UWCubeSat/minimee-electronics/containment/containment-simple.kicad_pcb

## KiCad design containment/containment-simple.kicad_pcb (2021-06-10)

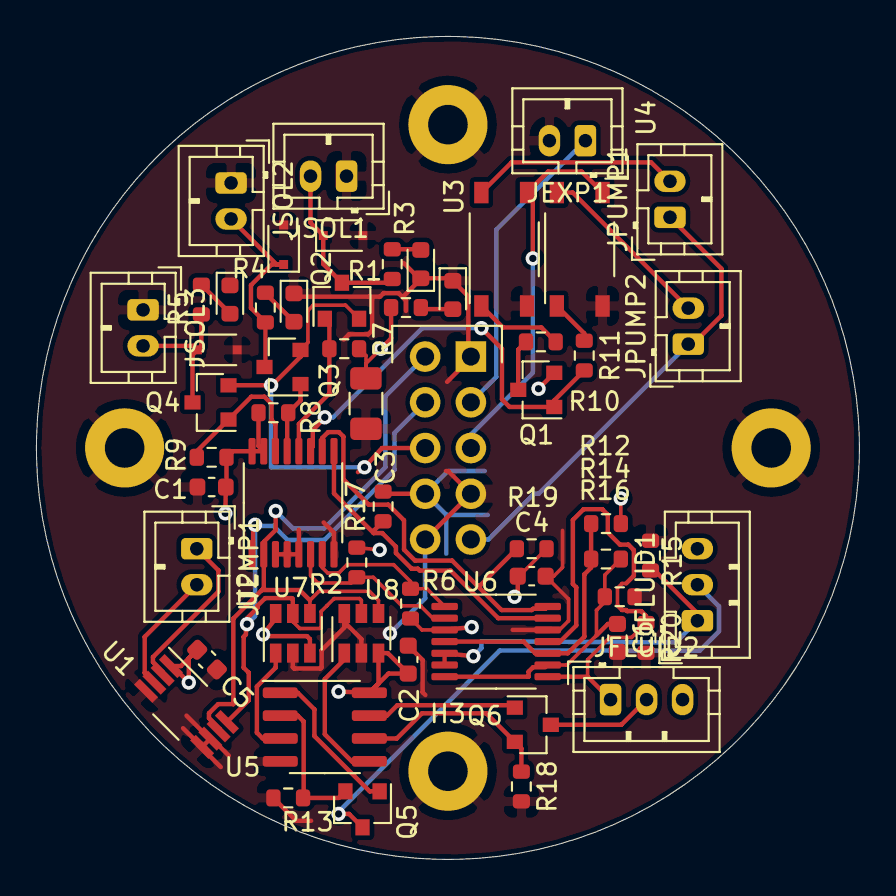
[picture p3: board containment-simple.kicad_pcb from above]

Board: 2 copper layers, 45.7 x 45.7 mm, 61 parts (1 on the bottom side), 42 nets.

Parts:
C1, C2, C4, C5, C6: .1uF; C_0603_1608Metric
C3: 10uF; C_1206_3216Metric
D1, D5, D7, D9: LED; LED_0603_1608Metric
D4, D6, D8: D; D_SOD-323F
H1, H2, H3, H4: MountingHole_Pad; MountingHole_2-56_ExtraClearance
J1: Conn_02x05_Odd_Even; PinHeader_2x05_P2.54mm_Vertical
JEXP1: Conn_01x02; JST_PH_B2B-PH-K_1x02_P2.00mm_Vertical
JFLUID1, JFLUID2: Conn_01x03; JST_PH_B3B-PH-K_1x03_P2.00mm_Vertical
JPUMP1, JPUMP2: Conn_01x02; JST_PH_B2B-PH-K_1x02_P2.00mm_Vertical
JSOL1, JSOL2, JSOL3: Conn_01x02; JST_PH_B2B-PH-K_1x02_P2.00mm_Vertical
JTEMP1: Conn_01x02; JST_PH_B2B-PH-K_1x02_P2.00mm_Vertical
Q1, Q2, Q3, Q4: BSS84; SOT-23
Q5, Q6: BC846; SOT-23
R1, R3, R4, R5: 1k; R_0603_1608Metric
R2, R6, R7, R8, R9, R12, R14, R15, R16, R17, R19, R20: 10k; R_0603_1608Metric
R10, R11: 470; R_0603_1608Metric
R13, R18: 50; R_0603_1608Metric
U1: TMP411; VSSOP-8_3.0x3.0mm_P0.65mm
U2: PCA9557; TSSOP-16_4.4x5mm_P0.65mm
U3, U4: TLP175A; MFSOP6-4_4.4x3.6mm_P1.27mm
U5: LM358; SOIC-8_3.9x4.9mm_P1.27mm
U6: LM339; TSSOP-14_4.4x5mm_P0.65mm
U7, U8: MCP4725xxx-xCH; SOT-23-6

Connections:
+5V: C1.1, C2.1, C3.1, C4.1, C5.1, J1.8, JFLUID1.3, JFLUID2.3, Q1.2, R1.1, R2.1, R6.1, R7.1, R8.1, R9.1, R12.1, R17.1, R19.1, U1.1, U2.15, U2.16, U5.8, U6.3, U7.3, U7.6, U8.3
+12V: J1.6, Q2.2, Q3.2, Q4.2
/Fluid Sensors/1_3rds: C6.1, R14.2, R16.1, U6.7, U6.9
/Fluid Sensors/2_3rds: R12.2, R14.1, U6.4, U6.10
/HV+: J1.9, JPUMP1.1, JPUMP2.1
/HV-: J1.5, U3.4, U4.4
/experiment: J1.3, JEXP1.1
/p0: R2.2, U2.6, U6.2
/p1: R6.2, U2.7, U6.1
/p2: R17.2, U2.9, U6.13
/p3: R19.2, U2.10, U6.14
/p4: Q1.1, R11.2, U2.11
/p5: Q2.1, R7.2, U2.12
/p6: Q3.1, R8.2, U2.13
/p7: Q4.1, R9.2, U2.14
GND: C1.2, C2.2, C3.2, C4.2, C5.2, C6.2, D1.1, D4.2, D5.1, D6.2, D7.1, D8.2, D9.1, H1.1, H2.1, H3.1, H4.1, J1.1, J1.7, J1.10, JEXP1.2, JSOL1.1, JSOL2.1, JSOL3.1, R13.2, R15.2, R16.2, R18.2, R20.2, U1.4, U1.5, U1.6, U2.3, U2.4, U2.5, U2.8, U3.3, U4.3, U5.4, U6.12, U7.2, U8.2, U8.6
unnamed: D1.2, R1.2
unnamed: D4.1, JSOL1.2, Q2.3, R3.1
unnamed: D5.2, R3.2
unnamed: D6.1, JSOL2.2, Q3.3, R4.1
unnamed: D7.2, R4.2
unnamed: D8.1, JSOL3.2, Q4.3, R5.1
unnamed: D9.2, R5.2
unnamed: JFLUID1.1, R15.1, U6.5, U6.6
unnamed: JFLUID1.2, Q5.3
unnamed: JFLUID2.1, R20.1, U6.8, U6.11
unnamed: JFLUID2.2, Q6.3
unnamed: JPUMP1.2, U3.6
unnamed: JPUMP2.2, U4.6
unnamed: JTEMP1.1, U1.2
unnamed: JTEMP1.2, U1.3
unnamed: Q1.3, R10.2
unnamed: Q5.1, U5.1
unnamed: Q5.2, R13.1, U5.2
unnamed: Q6.1, U5.7
unnamed: Q6.2, R18.1, U5.6
unnamed: R10.1, U3.1
unnamed: R11.1, U4.1
unnamed: U5.3, U7.1
unnamed: U5.5, U8.1
scl: J1.4, U1.8, U2.1, U7.5, U8.5
sda: J1.2, U1.7, U2.2, U7.4, U8.4
