UWCubeSat/minimee-electronics/spaceduino/spaceduino.kicad_pcb

## KiCad design spaceduino/spaceduino.kicad_pcb (2021-04-05)

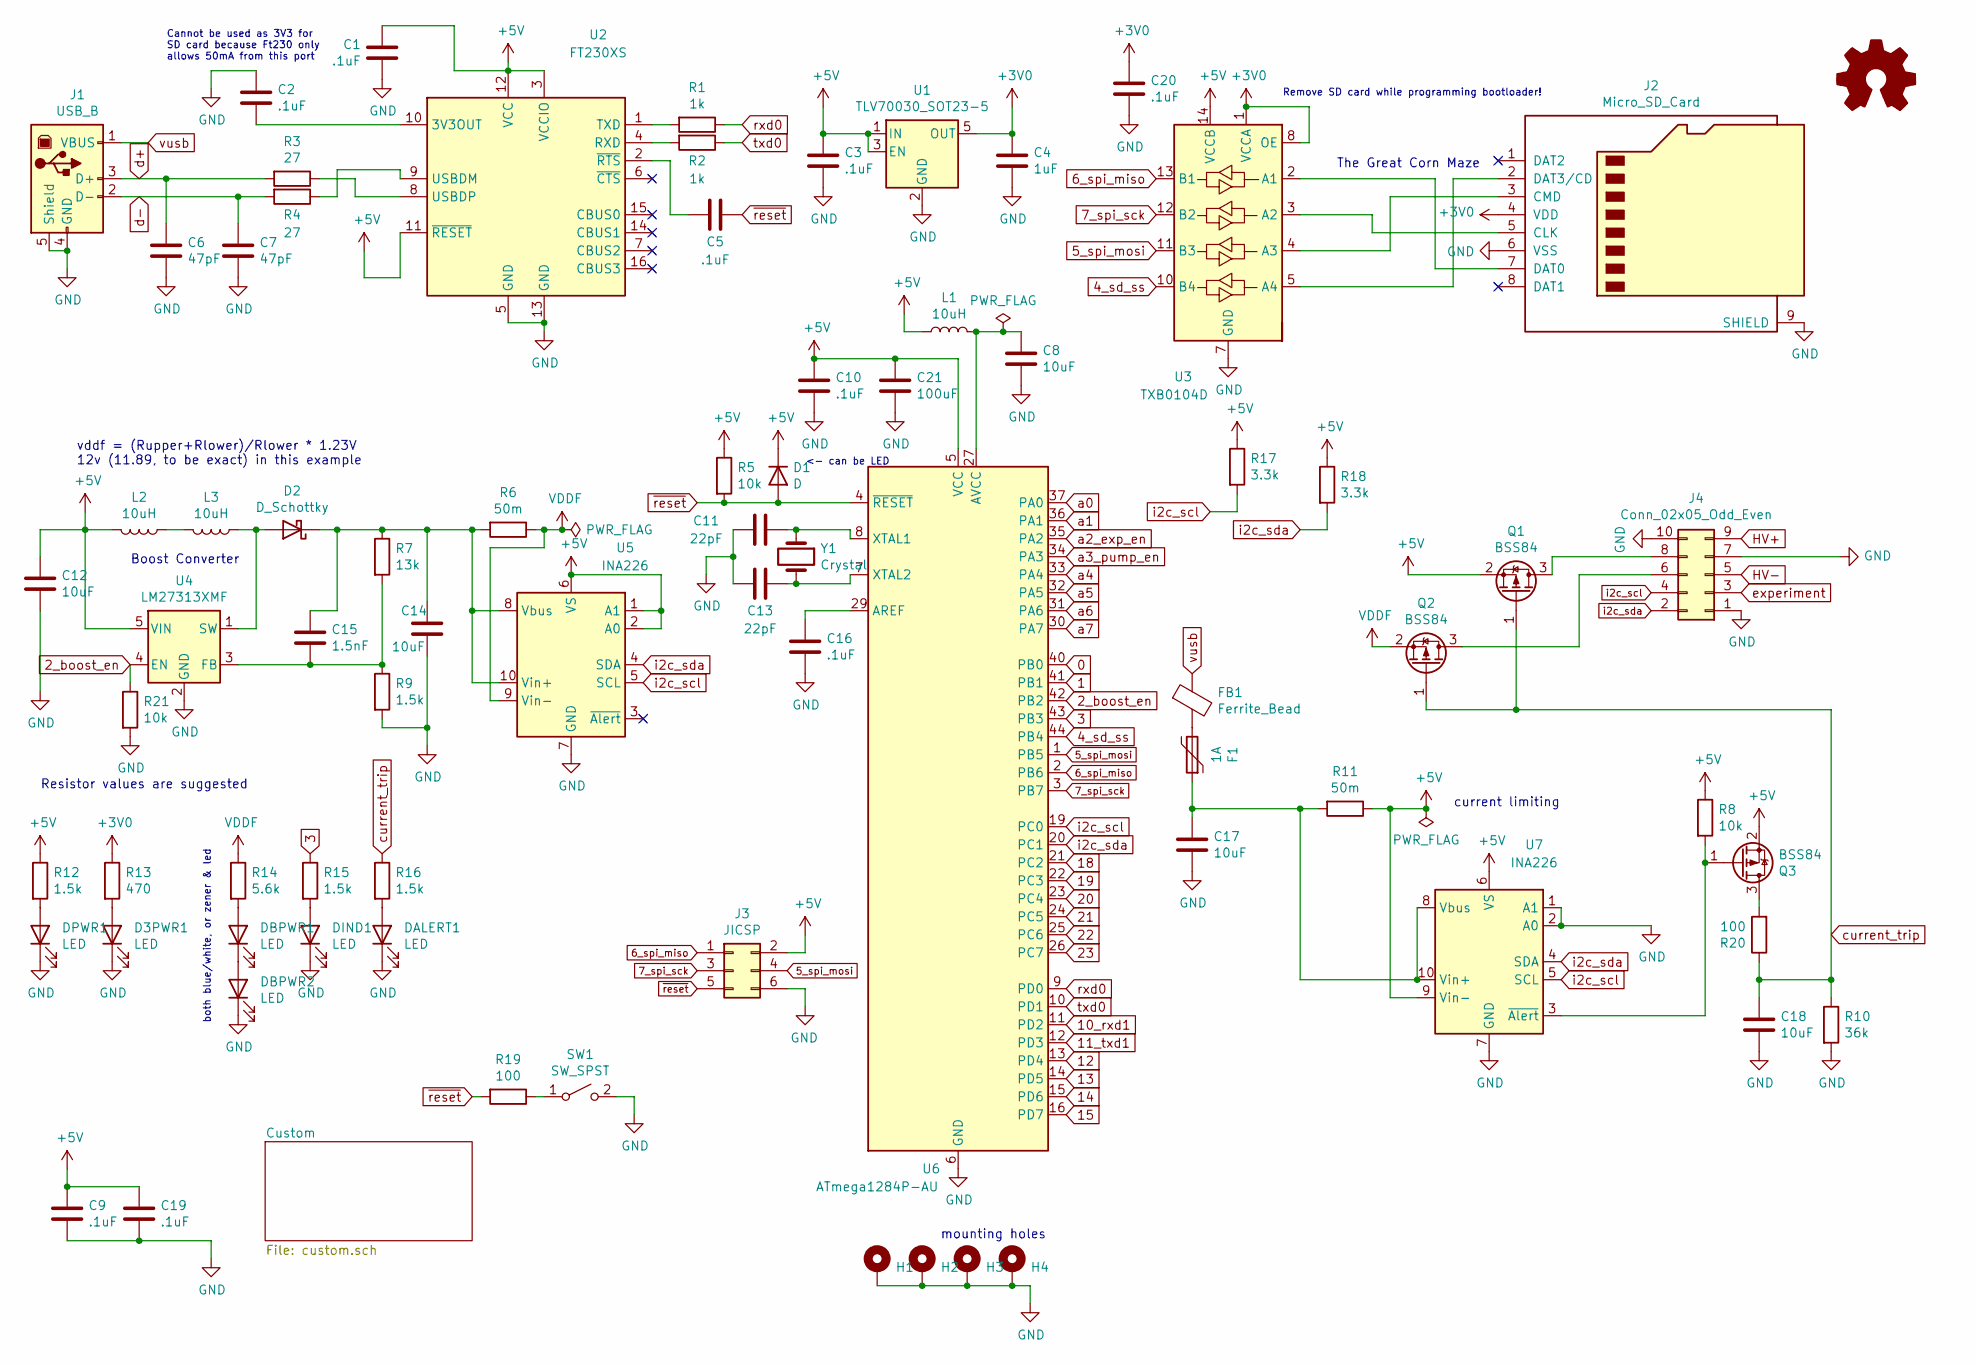
[picture p4: schematic spaceduino.sch]

Parts:
C1, C2, C3, C5, C9, C10, C16, C19, C20: .1uF; C_0603_1608Metric; LCSC C14663
C4: 1uF; C_1206_3216Metric; LCSC C1848
C6, C7: 47pF; C_0603_1608Metric; LCSC C1671
C8, C12, C14, C17, C18: 10uF; C_1206_3216Metric; LCSC C13585
C11, C13: 22pF; C_0603_1608Metric; LCSC C1653
C15: 1.5nF; C_0603_1608Metric; LCSC C1595
C21: 100uF; C_Radial_D5.0mm_H11.0mm_P2.00mm
D1: D; D_SOD-123; LCSC C8598
D2: D_Schottky; D_SOD-123; LCSC C8598
D3PWR1: LED; LED_0603_1608Metric; LCSC C72041
DALERT1: LED; LED_0603_1608Metric; LCSC C2286
DBPWR1, DBPWR2: LED; LED_0603_1608Metric; LCSC C72041
DIND1: LED; LED_0603_1608Metric; LCSC C72041
DPWR1: LED; LED_0603_1608Metric; LCSC C72041
F1: 1A; Fuse_1206_3216Metric; LCSC C315895
FB1: Ferrite_Bead; L_1206_3216Metric; LCSC C131463
H1, H2, H3, H4: MountingHole_Pad; MountingHole_2.2mm_M2_Pad
J1: USB_B; usb-type-b; Digikey 732-2734-ND
J2: Micro_SD_Card; HRS_DM3CS-SF
J3: JICSP; PinHeader_2x03_P2.54mm_Vertical
J4: Conn_02x05_Odd_Even; PinHeader_2x05_P2.54mm_Vertical
L1, L2, L3: 10uH; L_1210_3225Metric; LCSC C86073
LOGO1: Logo_Open_Hardware_Small; spaceduino-logo
Q1, Q2, Q3: BSS84; SOT-23; LCSC C10487
R1, R2: 1k; R_1206_3216Metric; LCSC C4410
R3, R4: 27; R_0603_1608Metric; LCSC C25190
R5, R8, R21: 10k; R_1206_3216Metric; LCSC C17902
R6, R11: 50m; R_1206_3216Metric; LCSC C201301
R7: 13k; R_0603_1608Metric; LCSC C22797
R9, R12, R15, R16: 1.5k; R_0603_1608Metric; LCSC C22843
R10: 36k; R_0603_1608Metric; LCSC C23147
R13: 470; R_1206_3216Metric; LCSC C17936
R14: 5.6k; R_0603_1608Metric; LCSC C23189
R17, R18: 3.3k; R_0603_1608Metric; LCSC C22978
R19, R20: 100; R_1206_3216Metric; LCSC C17901
SW1: SW_SPST; SolderJumper-2_P1.3mm_Open_TrianglePad1.0x1.5mm
U1: TLV70030_SOT23-5; SOT-23-5; Digikey 296-32412-1-ND
U2: FT230XS; SSOP-16_3.9x4.9mm_P0.635mm; Digikey 768-1135-1-ND
U3: TXB0104D; TSSOP-14_4.4x5mm_P0.65mm; Digikey 296-21928-1-ND
U4: LM27313XMF; SOT-23-5; LCSC C32355
U5, U7: INA226; VSSOP-10_3x3mm_P0.5mm; LCSC C49851
U6: ATmega1284P-AU; TQFP-44_10x10mm_P0.8mm; Digikey ATMEGA1284P-AURCT-ND
Y1: Crystal; Crystal_HC49-U_Vertical

Connections:
0: U6.40 (PB0)
1: U6.41 (PB1)
2_boost_en: R21.1, U4.4 (EN), U6.42 (PB2)
3: R15.1, U6.43 (PB3)
4_sd_ss: U3.10 (B4), U6.44 (PB4)
5_spi_mosi: J3.4, U3.11 (B3), U6.1 (PB5)
6_spi_miso: J3.1, U3.13 (B1), U6.2 (PB6)
7_spi_sck: J3.3, U3.12 (B2), U6.3 (PB7)
10_rxd1: U6.11 (PD2)
11_txd1: U6.12 (PD3)
12: U6.13 (PD4)
13: U6.14 (PD5)
14: U6.15 (PD6)
15: U6.16 (PD7)
18: U6.21 (PC2)
19: U6.22 (PC3)
20: U6.23 (PC4)
21: U6.24 (PC5)
22: U6.25 (PC6)
23: U6.26 (PC7)
+3V0: C4.1, C20.1, J2.4 (VDD), R13.1, U1.5 (OUT), U3.1 (VCCA), U3.8 (OE)
+5V: C1.1, C3.1, C9.1, C10.1, C12.1, C19.1, C21.1, D1.1 (K), J3.2, L1.1, L2.2, Q1.2 (S), Q3.2 (S), R5.1, R8.1, R11.1, R12.1, R17.1, R18.1, U1.1 (IN), U1.3 (EN), U2.3 (VCCIO), U2.11 (~RESET), U2.12 (VCC), U3.14 (VCCB), U4.5 (VIN), U5.1 (A1), U5.2 (A0), U5.6 (VS), U6.5 (VCC), U6.17 (VCC), U6.38 (VCC), U7.6 (VS), U7.9 (Vin-); also elsewhere on the board
GND: C1.2, C2.1, C3.2, C4.2, C6.2, C7.2, C8.2, C9.2, C10.2, C11.2, C12.2, C13.2, C14.2, C16.2, C17.2, C18.2, C19.2, C20.2, C21.2, D3PWR1.1 (K), DALERT1.1 (K), DBPWR2.1 (K), DIND1.1 (K), DPWR1.1 (K), H1.1, H2.1, H3.1, H4.1, J1.4 (GND), J1.5 (Shield), J2.6 (VSS), J2.9 (SHIELD), J3.6, J4.1, J4.7, J4.10, R9.2, R10.2, R21.2, SW1.2 (B), U1.2 (GND), U2.5 (GND), U2.13 (GND), U3.7 (GND), U4.2 (GND), U5.7 (GND), U6.6 (GND), U6.18 (GND), U6.28 (GND), U6.39 (GND), U7.1 (A1), U7.2 (A0), U7.7 (GND); also elsewhere on the board
HV+: J4.9; also elsewhere on the board
HV-: J4.5; also elsewhere on the board
unnamed: C2.2, U2.10 (3V3OUT)
unnamed: C5.2, U2.2 (~RTS)
unnamed: C8.1, L1.2, U6.27 (AVCC)
unnamed: C11.1, U6.8 (XTAL1), Y1.1
unnamed: C13.1, U6.7 (XTAL2), Y1.2
unnamed: C14.1, C15.1, D2.1 (K), R6.2, R7.1, U5.8 (Vbus), U5.10 (Vin+)
unnamed: C15.2, R7.2, R9.1, U4.3 (FB)
unnamed: C16.1, U6.29 (AREF)
unnamed: C17.1, F1.1, R11.2, U7.8 (Vbus), U7.10 (Vin+)
unnamed: D2.2 (A), L3.1, U4.1 (SW)
unnamed: D3PWR1.2 (A), R13.2
unnamed: DALERT1.2 (A), R16.2
unnamed: DBPWR1.1 (K), DBPWR2.2 (A)
unnamed: DBPWR1.2 (A), R14.2
unnamed: DIND1.2 (A), R15.2
unnamed: DPWR1.2 (A), R12.2
unnamed: F1.2, FB1.2
unnamed: J2.2 (DAT3/CD), U3.5 (A4)
unnamed: J2.3 (CMD), U3.4 (A3)
unnamed: J2.5 (CLK), U3.3 (A2)
unnamed: J2.7 (DAT0), U3.2 (A1)
unnamed: J4.6, Q2.3 (D)
unnamed: J4.8, Q1.3 (D)
unnamed: L2.1, L3.2
unnamed: Q3.1 (G), R8.2, U7.3 (~Alert~)
unnamed: Q3.3 (D), R20.2
unnamed: R1.2, U2.1 (TXD)
unnamed: R2.2, U2.4 (RXD)
unnamed: R3.1, U2.8 (USBDP)
unnamed: R4.1, U2.9 (USBDM)
unnamed: R19.1, SW1.1 (A)
VDDF: Q2.2 (S), R6.1, R14.1, U5.9 (Vin-)
a0: U6.37 (PA0)
a1: U6.36 (PA1)
a2_exp_en: U6.35 (PA2); also elsewhere on the board
a3_pump_en: U6.34 (PA3); also elsewhere on the board
a4: U6.33 (PA4)
a5: U6.32 (PA5)
a6: U6.31 (PA6)
a7: U6.30 (PA7)
current_trip: C18.1, Q1.1 (G), Q2.1 (G), R10.1, R16.1, R20.1
d+: C6.1, J1.3 (D+), R3.2
d-: C7.1, J1.2 (D-), R4.2
experiment: J4.3; also elsewhere on the board
i2c_scl: J4.4, R17.2, U5.5 (SCL), U6.19 (PC0), U7.5 (SCL); also elsewhere on the board
i2c_sda: J4.2, R18.2, U5.4 (SDA), U6.20 (PC1), U7.4 (SDA); also elsewhere on the board
rxd0: R1.1, U6.9 (PD0)
txd0: R2.1, U6.10 (PD1)
vusb: FB1.1, J1.1 (VBUS)
~reset: C5.1, D1.2 (A), J3.5, R5.2, R19.2, U6.4 (~RESET)

Notes on the sheet:
Boost Converter
The Great Corn Maze
Cannot be used as 3V3 for SD card because Ft230 only allows 50mA from this port
Remove SD card while programming bootloader!
vddf = (Rupper+Rlower)/Rlower * 1.23V 12v (11.89, to be exact) in this example
Resistor values are suggested
mounting holes
current limiting
<- can be LED
both blue/white, or zener & led

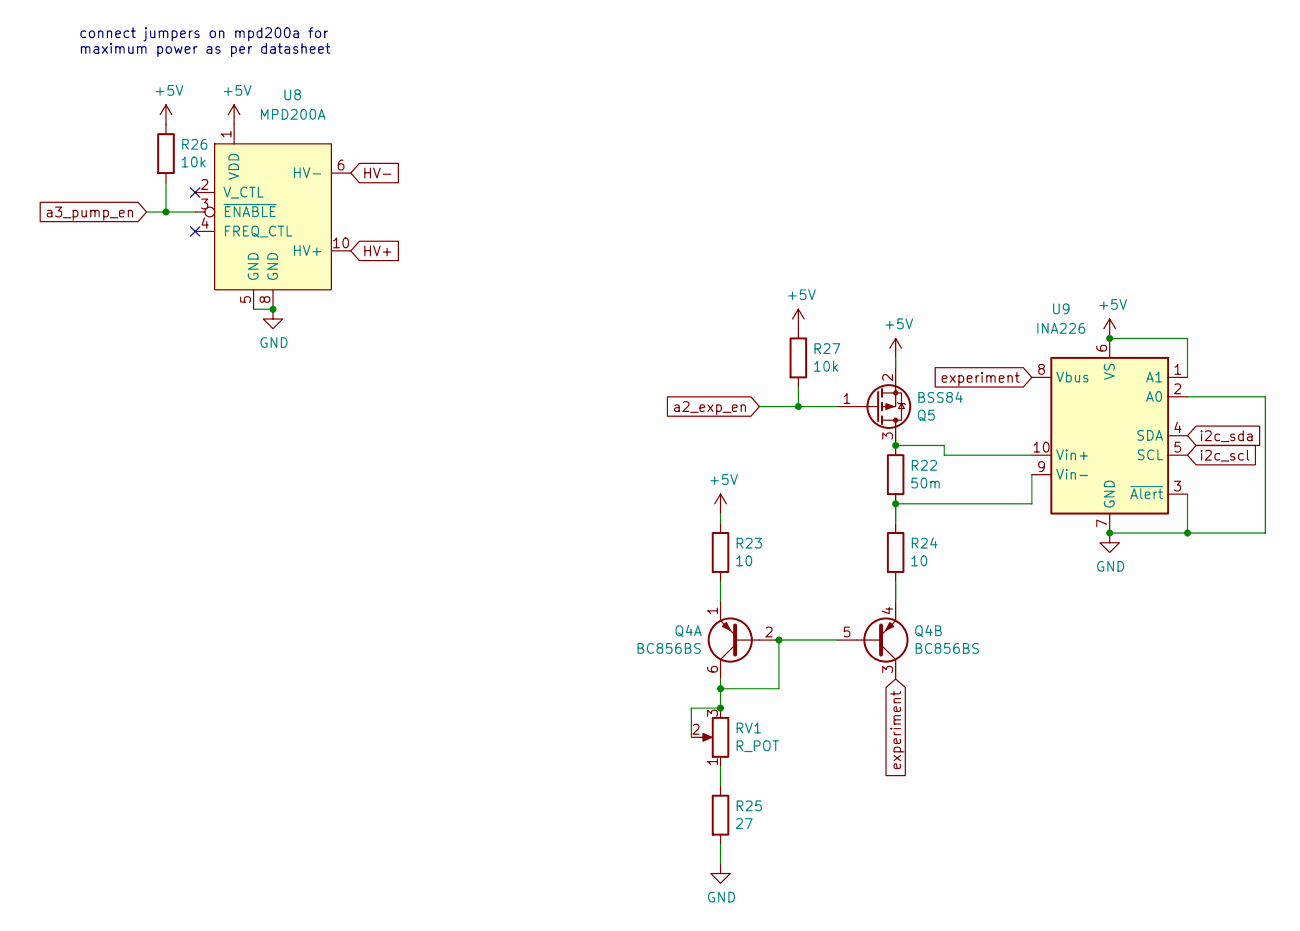
[picture p5: schematic custom.sch]

Parts:
Q4: BC856BS; SOT-363_SC-70-6; LCSC C105896
Q5: BSS84; SOT-23; LCSC C10487
R22: 50m; R_1206_3216Metric; LCSC C201301
R23, R24: 10; R_1206_3216Metric; LCSC C17903
R25: 27; R_0603_1608Metric; LCSC C25190
R26, R27: 10k; R_1206_3216Metric; LCSC C17902
RV1: R_POT; Potentiometer_Bourns_3296Y_Vertical
U8: MPD200A
U9: INA226; VSSOP-10_3x3mm_P0.5mm; LCSC C49851

Connections:
+5V: Q5.2 (S), R23.1, R26.1, R27.1, U8.1 (VDD), U9.1 (A1), U9.6 (VS); also elsewhere on the board
GND: R25.2, U8.5 (GND), U8.8 (GND), U9.2 (A0), U9.3 (~Alert~), U9.7 (GND); also elsewhere on the board
HV+: U8.10 (HV+); also elsewhere on the board
HV-: U8.6 (HV-); also elsewhere on the board
unnamed: Q4.1 (E1), R23.2
unnamed: Q4.2 (B1), Q4.5 (B2), Q4.6 (C1), RV1.2, RV1.3
unnamed: Q4.4 (E2), R24.2
unnamed: Q5.3 (D), R22.1, U9.10 (Vin+)
unnamed: R22.2, R24.1, U9.9 (Vin-)
unnamed: R25.1, RV1.1
a2_exp_en: Q5.1 (G), R27.2; also elsewhere on the board
a3_pump_en: R26.2, U8.3 (~ENABLE); also elsewhere on the board
experiment: Q4.3 (C2), U9.8 (Vbus); also elsewhere on the board
i2c_scl: U9.5 (SCL); also elsewhere on the board
i2c_sda: U9.4 (SDA); also elsewhere on the board

Notes on the sheet:
connect jumpers on mpd200a for maximum power as per datasheet

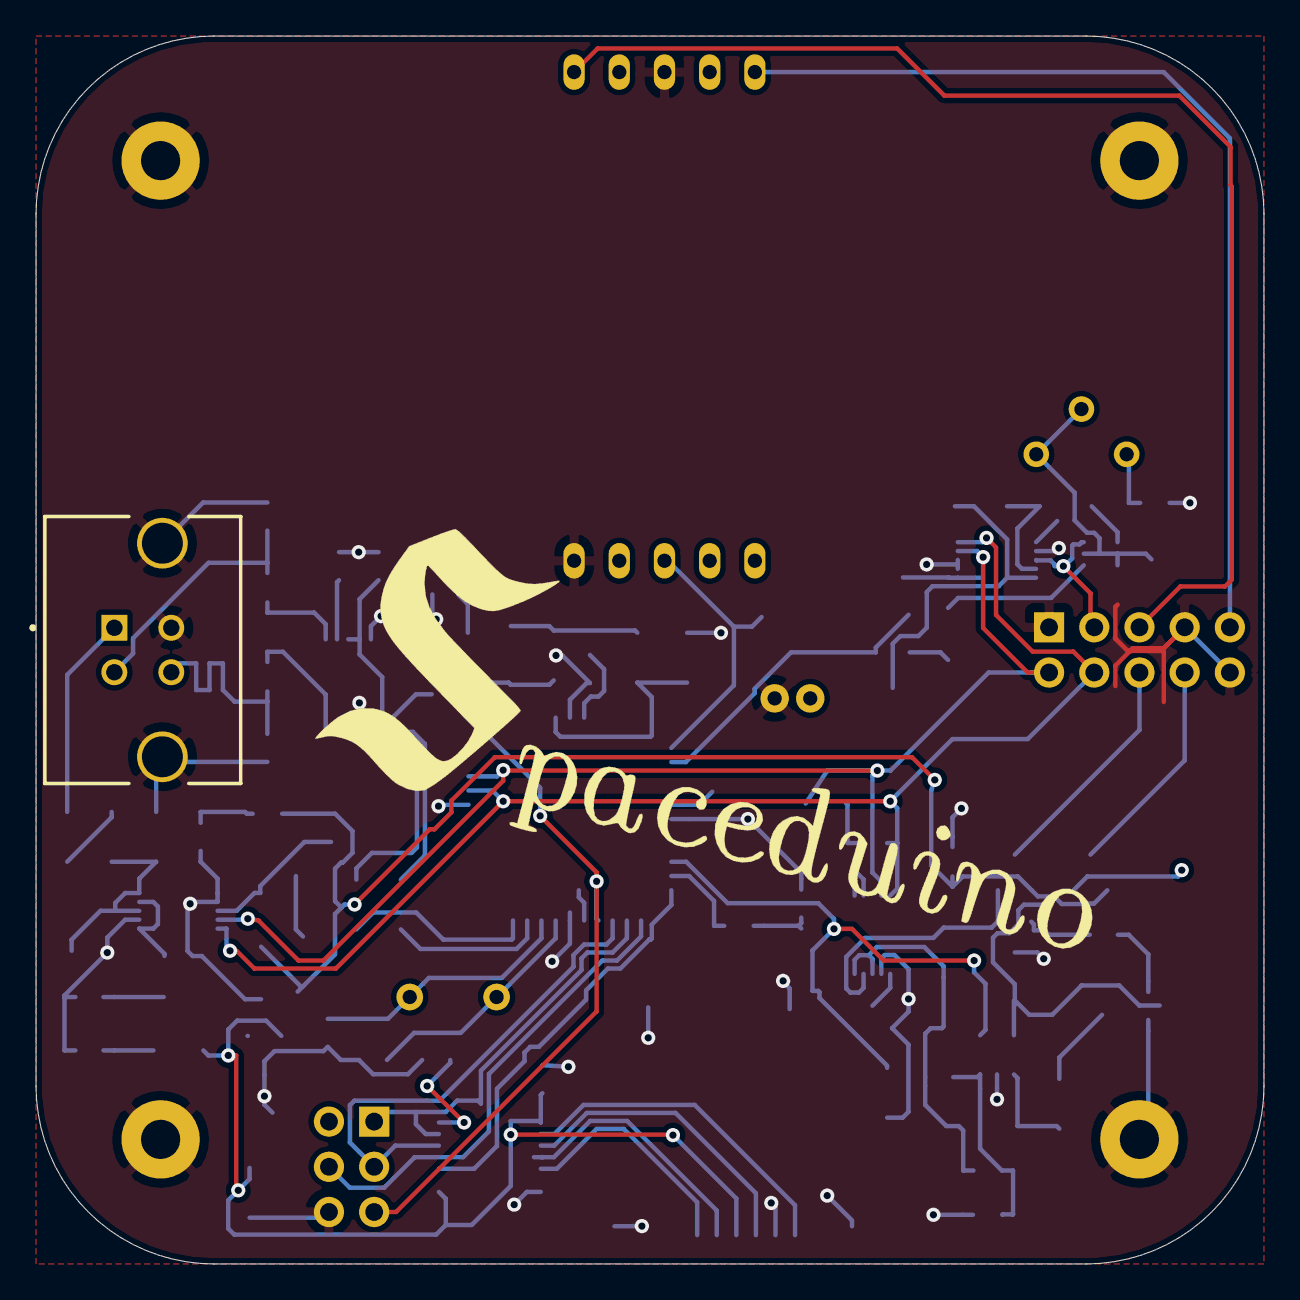
[picture p6: board spaceduino.kicad_pcb from above]

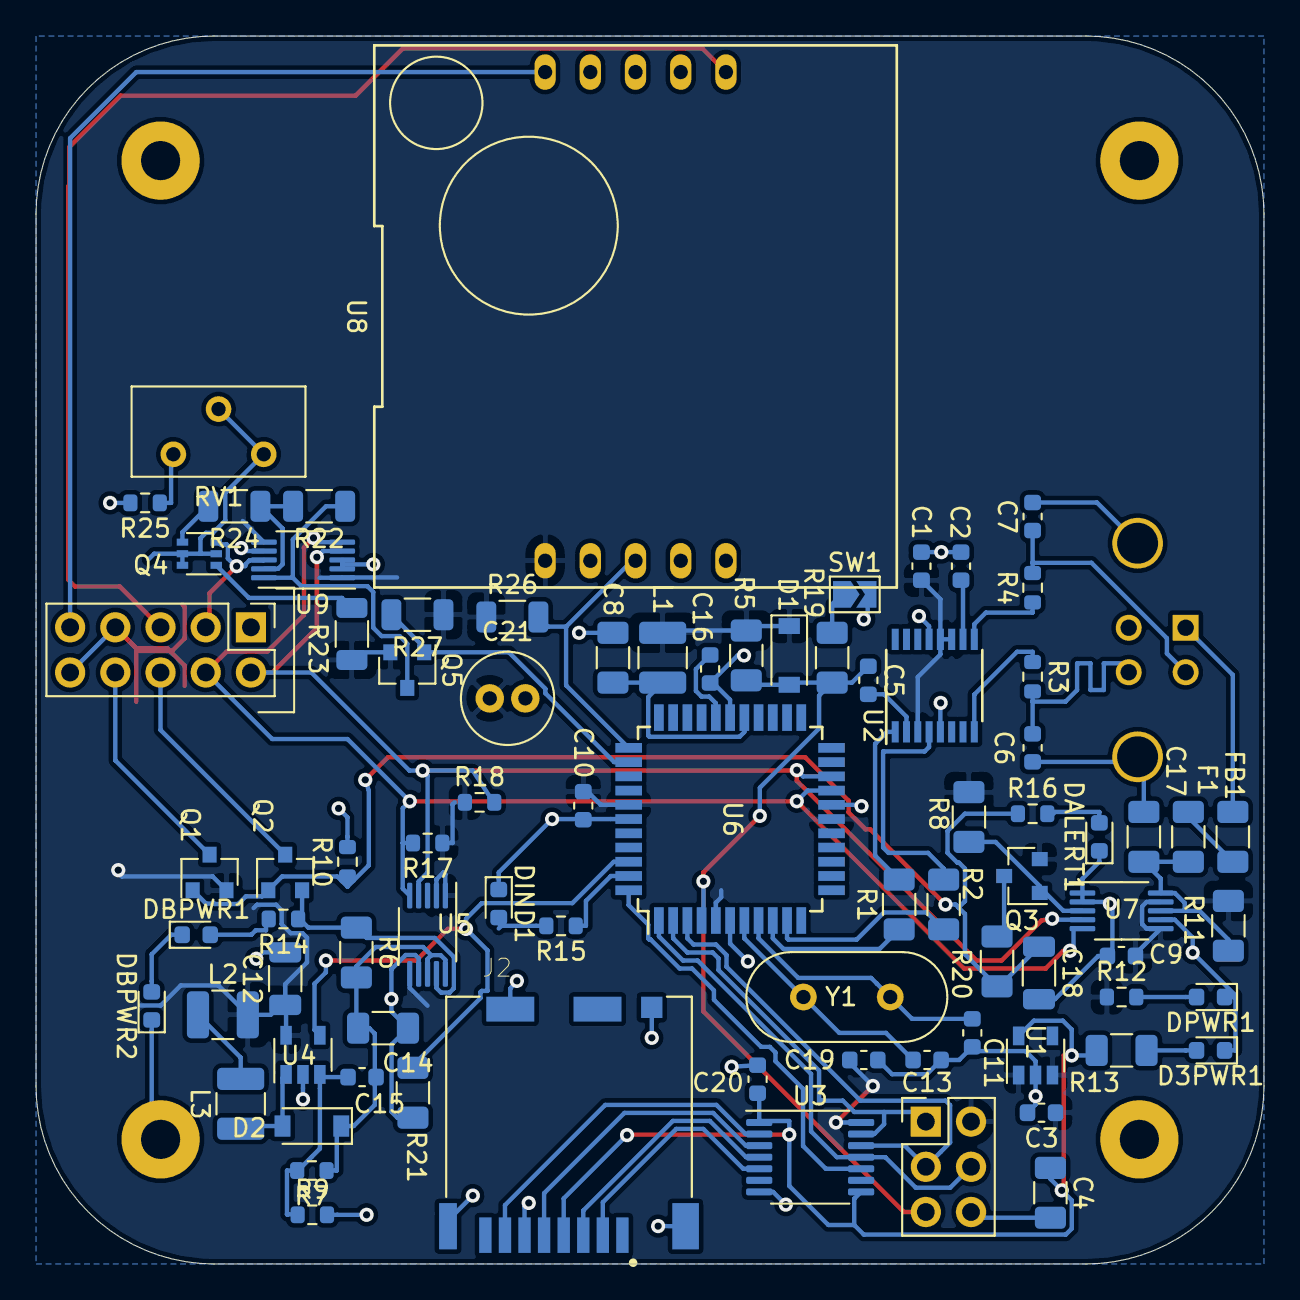
[picture p7: board spaceduino.kicad_pcb from below]

Board: 2 copper layers, 69.0 x 69.0 mm, 87 parts (81 on the bottom side), 61 nets.
