UWCubeSat/minimee-electronics/(commit log)

2020-12-20 copied stuff from BONK
    [ESQ-105-13-L-D.stp, containment-inter.kicad_pcb, containment-inter.sch, containment-simple.kicad_pcb, containment-simple.sch, custom.sch, spaceduino.kicad_pcb, spaceduino.sch]
2020-12-21 add spixes
    [containment-simple.kicad_pcb, containment-simple.sch]
2020-12-21 spikey 2
    [containment-simple.kicad_pcb, containment-simple.sch]
2021-01-06 use the correct optocoupler
    [containment-simple.kicad_pcb, containment-simple.sch]
2021-01-06 add SD card footprint, PNP-based current mirror
    [custom.sch, spaceduino.kicad_pcb, spaceduino.sch]
2021-01-12 move more parts to jlcsmt catalog
    [custom.sch, spaceduino.sch]
2021-02-07 Added a BJT current mirror using BC846BDW1 NPN BJT's
    [spaceduino.sch]
2021-02-07 Filled some traces for Q4 and U6, need thicker power trace
    [spaceduino.kicad_pcb]
2021-02-08 Added 500901-0801 Micro SD Socket (locking lid) to schematic, footprint and symbol library, removed current mirror
    [spaceduino.sch]
2021-02-09 Assigned footprints for SD Card, potentiometer, and resistors
    [custom.sch, spaceduino.sch]
2021-02-17 start fluid sensor
    [containment-simple.sch, fluid-sensors.sch]
2021-03-15 inner containment baord lookin pretty good
    [containment-simple.kicad_pcb, containment-simple.sch, fluid-sensors.sch, spaceduino.sch]
2021-03-18 spaceduino laid out???
    [custom.sch, spaceduino.kicad_pcb, spaceduino.sch]
2021-03-19 use sd card that is actually in stock on digikey
    [custom.sch, spaceduino.kicad_pcb, spaceduino.sch]
2021-03-20 can i get a go dawgs
    [containment-simple.kicad_pcb, custom.sch, fluid-sensors.sch, spaceduino.kicad_pcb, spaceduino.sch]
2021-04-05 ordered it supposedly
    [containment-simple.kicad_pcb, containment-simple.sch, custom.sch, fluid-sensors.sch, spaceduino.kicad_pcb, spaceduino.sch]
2021-06-10 containment schematic updated to include experiment & correct voltage on valve mosfets
    [containment-inter.kicad_pcb, containment-simple.kicad_pcb, containment-simple.sch, experiments.sch, fluid-sensors.sch]
