UWCubeSat/minimee-electronics/(notices)

Notices in the files:
containment-inter/ESQ-105-13-L-D.stp:
FILE_NAME( 'p:/temp/worker_887/temp/exporttempdir_2880_70_46KpP/format_0/ESQ-105-13-L-D.stp', '2020-07-22T18:38:51', ( 'License CC BY-ND 4.0' ), ( 'CADENAS' ), ' ', 'PARTsolutions', ' ' );
